dirkx/esp-rfid-oled/board-1.01-jlcpcb-back.jpeg

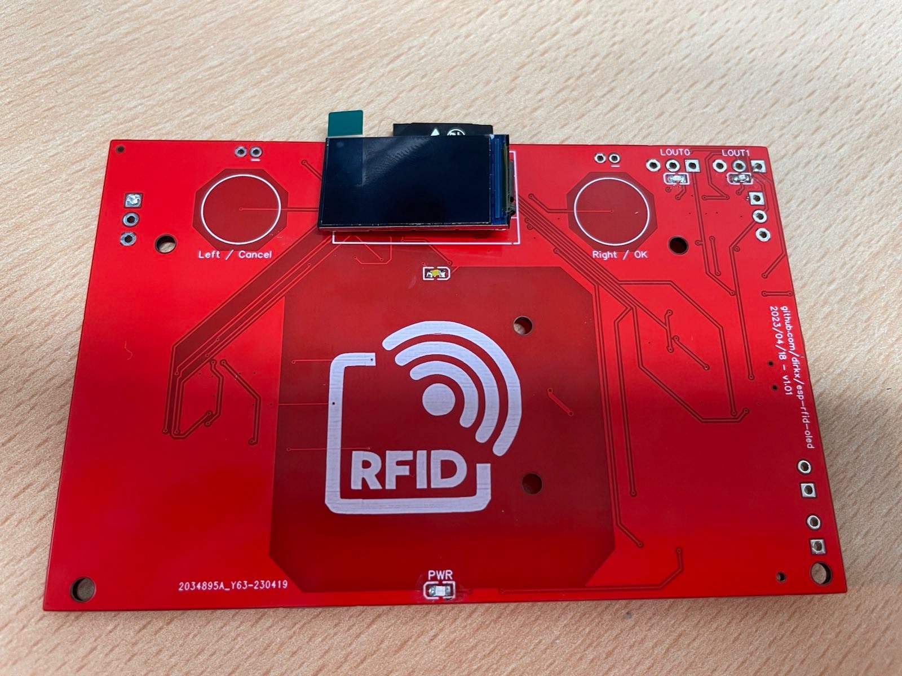
board-1.01-jlcpcb-back.jpeg
