dirkx/esp-rfid-oled/board-1.01-jclpcb-front.jpeg

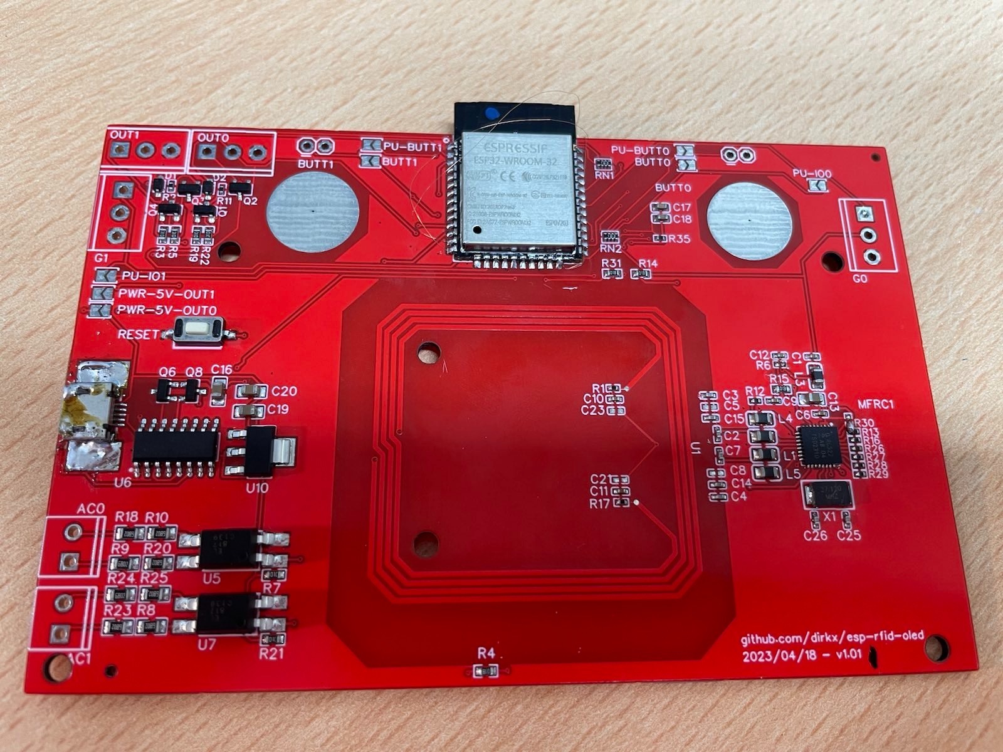
board-1.01-jclpcb-front.jpeg
