dirkx/esp-rfid-oled/README.md

Board with an ESP32, OLED display, a RFID reader; some optocouplers to sense AC, touch buttons, general IO and some drivers (e.g. for relays).

Investigation for improving things at https://wiki.makerspaceleiden.nl/mediawiki/index.php/Categorie:ACNode -- and in particular the sort of node in use at https://wiki.makerspaceleiden.nl/mediawiki/index.php/Payment_Terminal_with_TFT_screen.

Version 1.01 was fabbed (see photo's); note that the schematics for 1.02 fix the 3 rework issues.

See https://oshwlab.com/dirkx/stm25-reference-design_copy for an easy to order version at EasyEDA / JLCPCB
