dirkx/esp-rfid-oled/board-1.01-3D-back.png

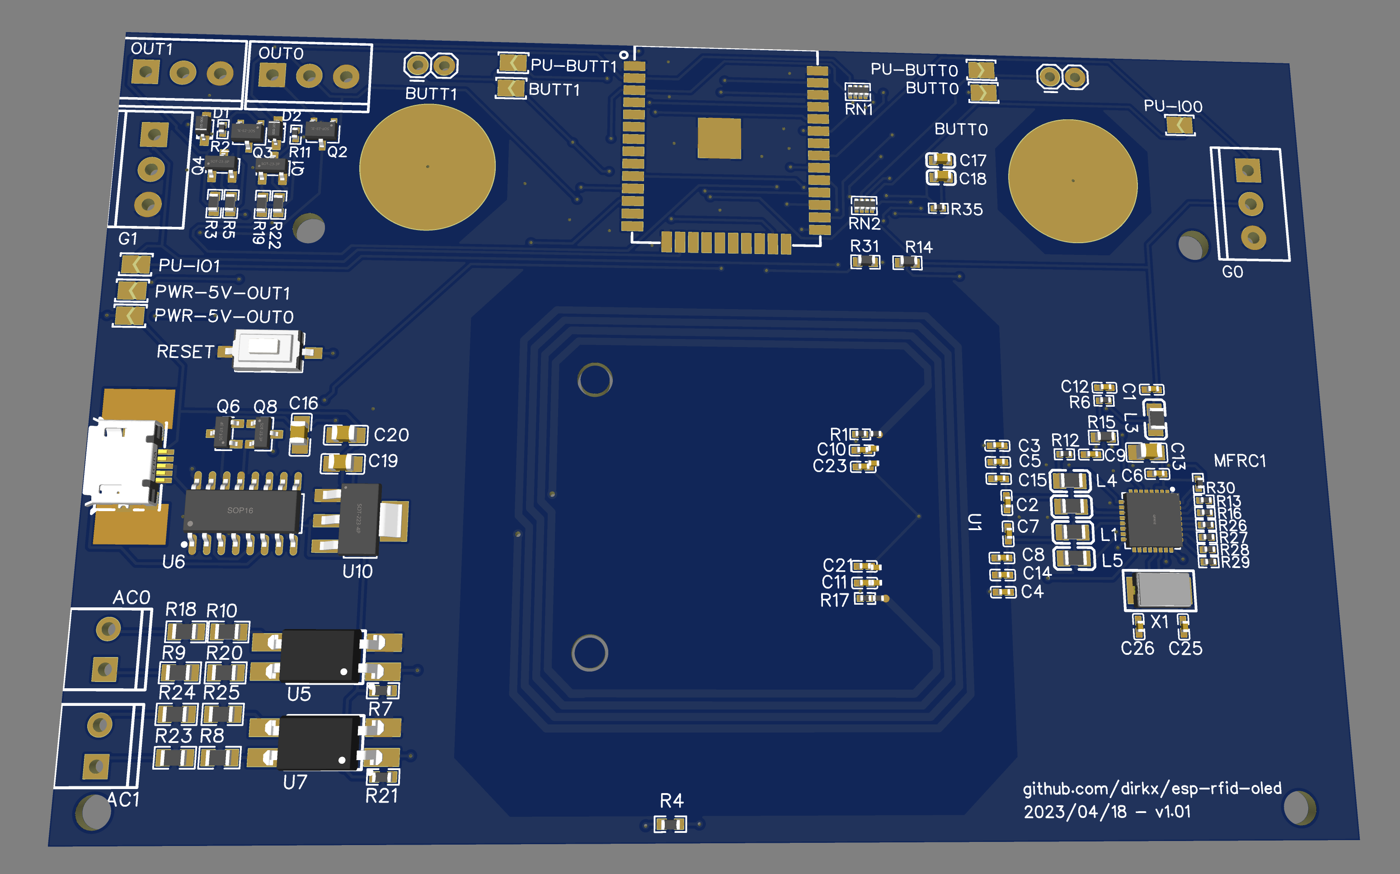
board-1.01-3D-back.png
