dirkx/esp-rfid-oled/board-1.01-3D-front.png

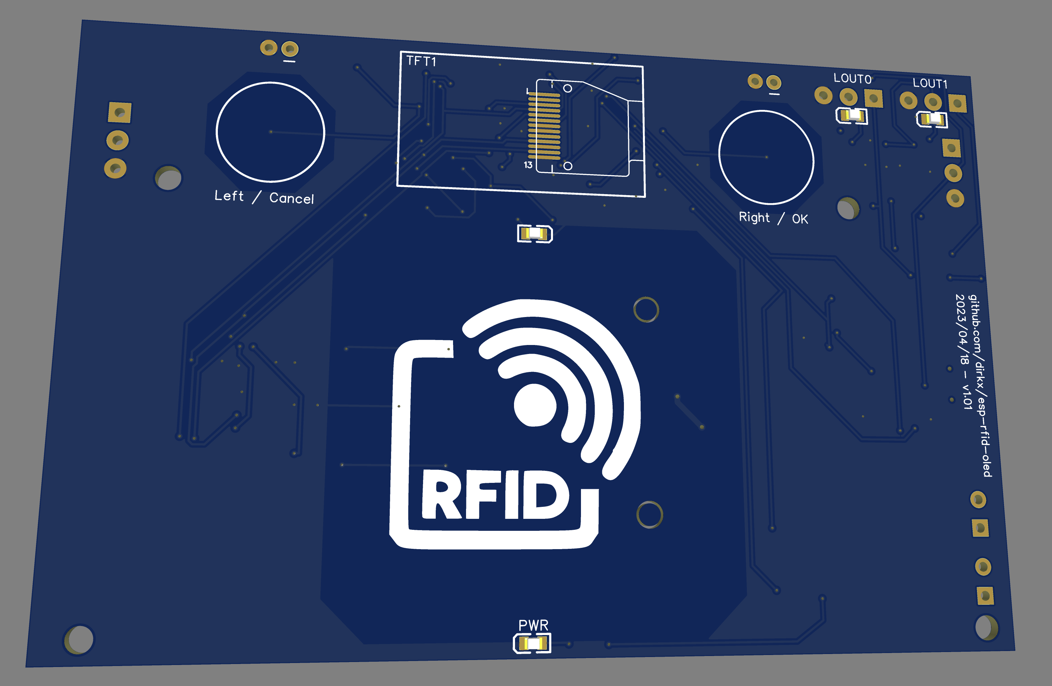
board-1.01-3D-front.png
