dirkx/esp-rfid-oled/schematic-v1.02.pdf

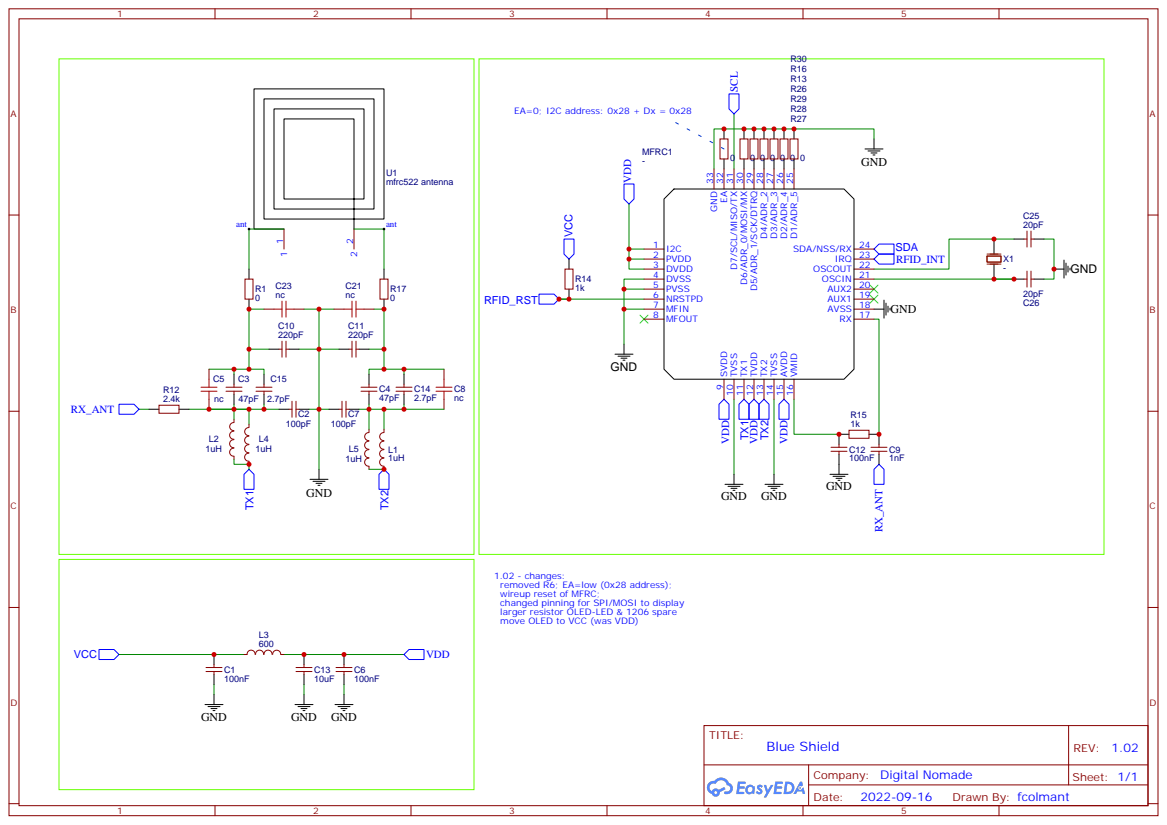
[picture p5: page 1]

RX 17 AVSS 18 AUX1 19 AUX2 20 OSCIN 21 OSCOUT 22 IRQ 23 SDA/NSS/RX 24 D¹/ADR_5 25 D²/ADR_4 26 D³/ADR_3 27 D⁴/ADR_2 28 D⁵/ADR_1/SCK/DTRQ ²⁹ D⁶/ADR_0/MOSI/MX 30 D⁷/SCL/MISO/TX 31 EA 32 GND ³³

1.02 - changes:
removed R6; EA=low (0x28 address);
wireup reset of MFRC;
changed pinning for SPI/MOSI to display
larger resistor OLED-LED & 1206 spare
move OLED to VCC (was VDD)

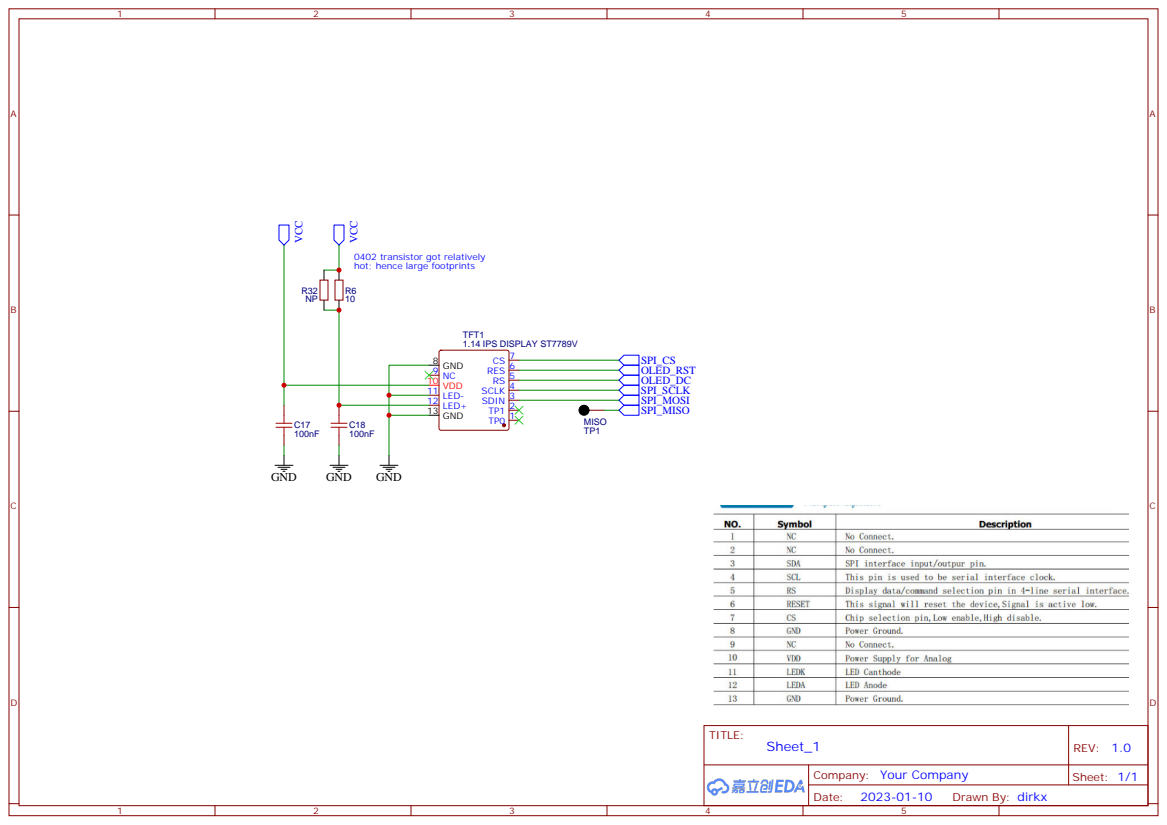
[picture p6: page 2]

0402 transistor got relatively
hot; hence large footprints

## Label turns overlaps rfid logo back add version # to board

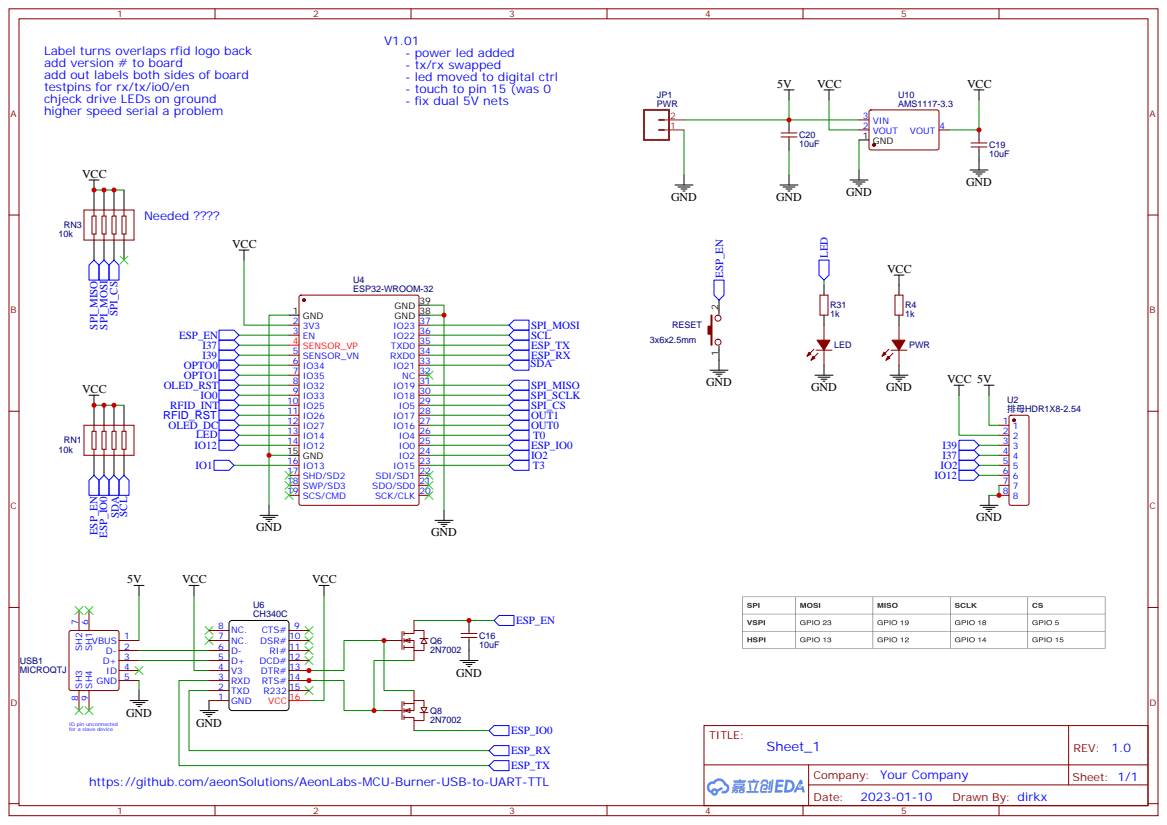
[picture p7: page 3]

- power led added
- tx/rx swapped
- led moved to digital ctrl
- touch to pin 15 (was 0
- fix dual 5V nets

add out labels both sides of board
testpins for rx/tx/io0/en
chjeck drive LEDs on ground
higher speed serial a problem

https://github.com/aeonSolutions/AeonLabs-MCU-Burner-USB-to-UART-TTL

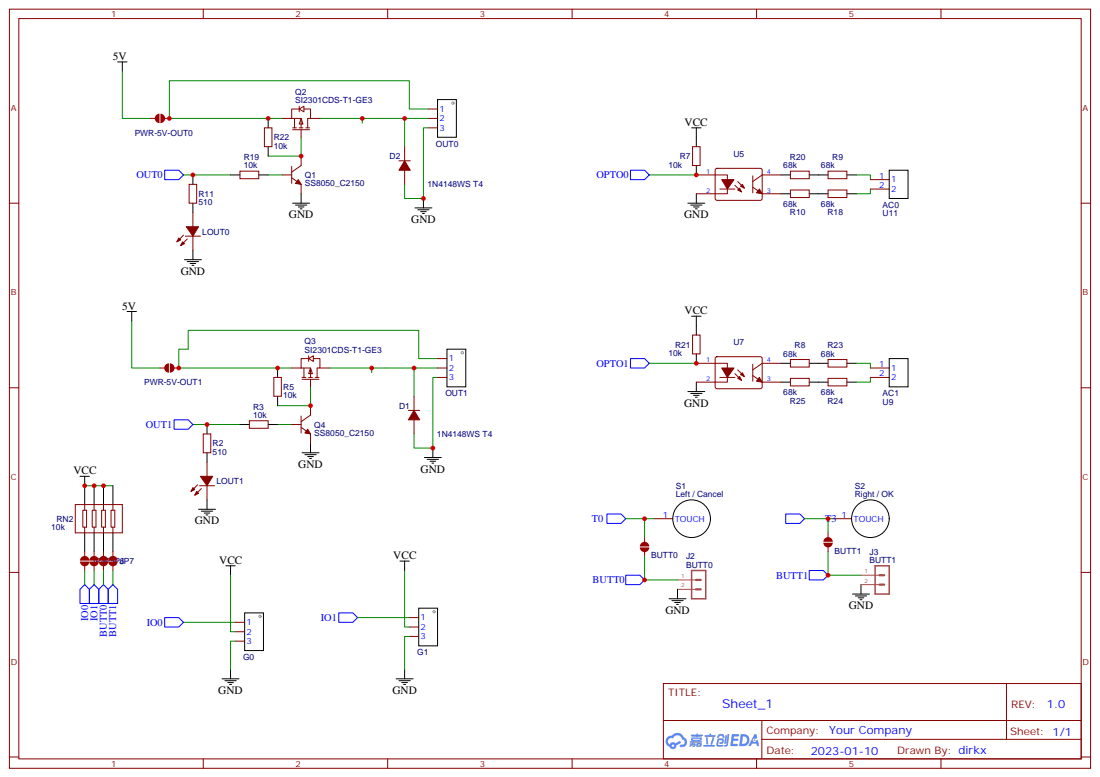
[picture p8: page 4]
