dirkx/esp-rfid-oled/schematic-v1.01.pdf

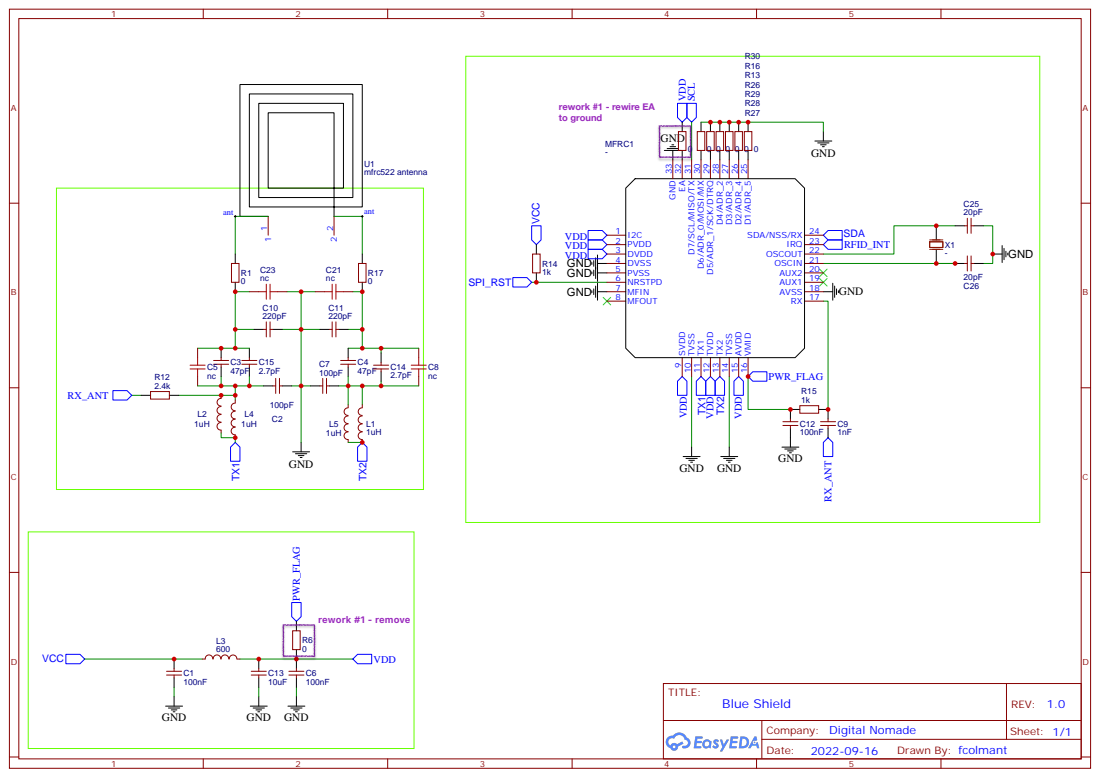
[picture p9: page 1]

GND
RX 17 AVSS 18 AUX1 19 AUX2 20 OSCIN 21 OSCOUT 22 IRQ 23 SDA/NSS/RX 24 D¹/ADR_5 25 D²/ADR_4 26 D³/ADR_3 27 D⁴/ADR_2 28 D⁵/ADR_1/SCK/DTRQ ²⁹ D⁶/ADR_0/MOSI/MX 30 D⁷/SCL/MISO/TX 31 EA 32 GND ³³

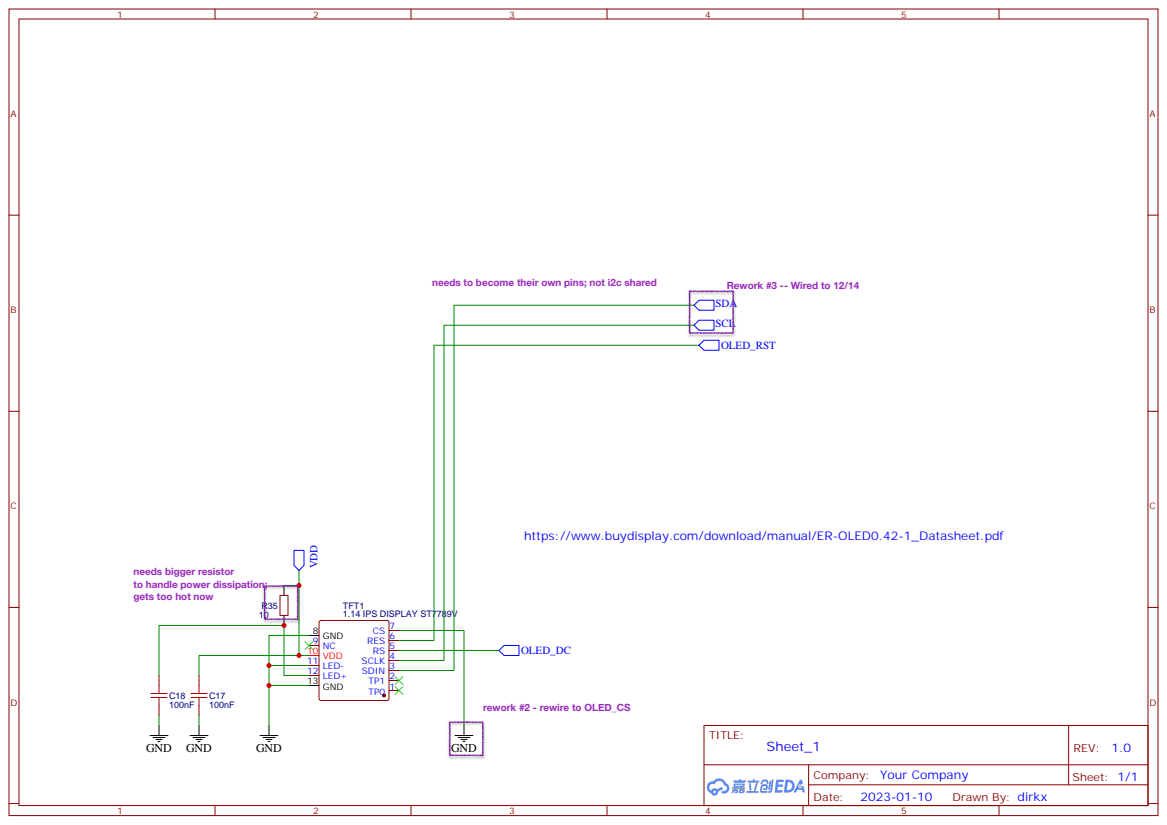
[picture p10: page 2]
TITLE:; Sheet_1; REV: 1.0; Date:; OLED_RST; SDA; SCL; 1.14 IPS DISPLAY ST7789V; TFT1; SDIN 3; SCLK 4; RES 6; GND 8 NC 9 VDD 10 LED- 11 LED+ 12 GND 13; GND; VDD; OLED_DC; GND GND

https://www.buydisplay.com/download/manual/ER-OLED0.42-1_Datasheet.pdf

Company: Your Company

Drawn By: dirkx

## Label turns overlaps rfid logo back add version # to board

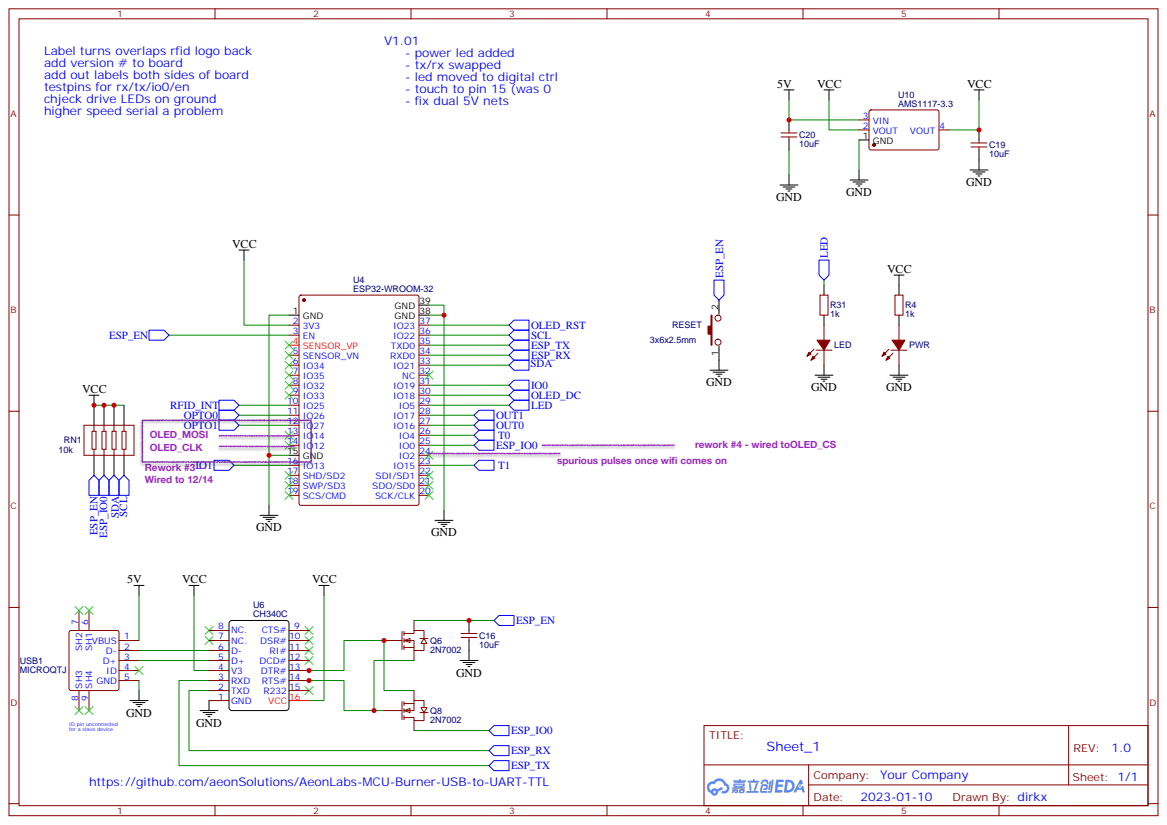
[picture p11: page 3]

- power led added
- tx/rx swapped
- led moved to digital ctrl
- touch to pin 15 (was 0
- fix dual 5V nets

add out labels both sides of board
testpins for rx/tx/io0/en
chjeck drive LEDs on ground
higher speed serial a problem

https://github.com/aeonSolutions/AeonLabs-MCU-Burner-USB-to-UART-TTL

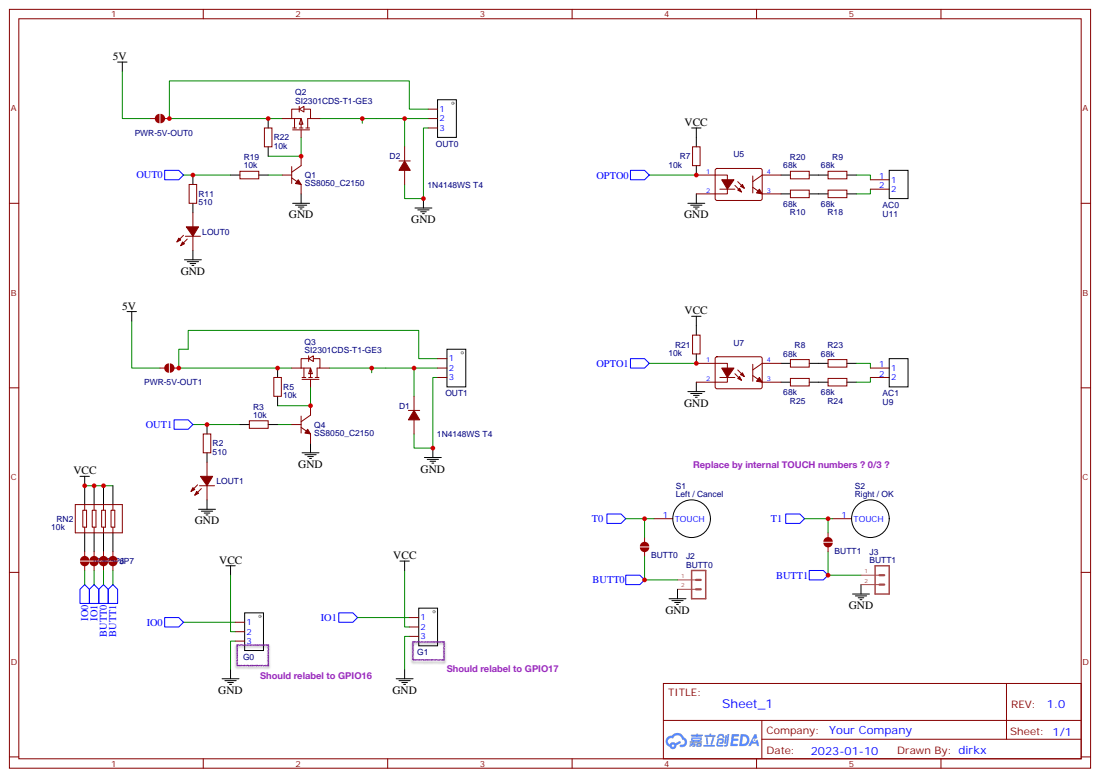
[picture p12: page 4]
