dirkx/esp-rfid-oled/(commit log)

2023-05-25 Snapshot of 1.01 board bringup; and rework 1-3
    [01_bringup_led.ino, 02_bringup_serial.ino, 03_bringup_i2c_scan.ino, 03_bringup_oled.ino, 03_bringup_rfid.ino, 03_bringup_rfid_irq.ino, 03_bringup_rfid_irq_oled.ino, 04_msl_test.ino]
2023-05-26 Rework #4 of 1.01 board -- spurious pulses on GPIO2 once wifi comes on; so moved to GPIO0
    [04_msl_test.ino]
